WhitneyDesignLabs/STT-Dongle/(commit log)

2026-05-30 Initial commit: STT Keyboard Dongle (v0) — firmware, Android app, tooling, docs
    Phone speech-to-text -> BLE -> ESP32 USB-HID keyboard. Validated end-to-end on an
    ESP32-C6 BLE proxy; ESP32-S3 (HID-capable) board on order.
    - firmware/ ESP32-S3 production: USB-HID + bonded BLE GATT + Enter/Tab/Backspace (compiles)
    - firmware-ble-test/ ESP32-C6 BLE proxy: serial echo, LED activity, CLEAN_SERIAL + REQUIRE_BONDING flags
    - android/ (v0.7.0) Kotlin app: dictation, BLE console, multi-dongle, special keys (voice+buttons),
    keep-screen-awake, on-screen version
    - tools/ stt_send.py (BLE harness), serial_type.py (Windows software-HID), watch-install.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
2026-05-30 v0.8: working end-to-end STT -> BLE -> serial-bridge -> host insertion
    Full loop is functional on the ESP32-C6 stand-in (S3 USB-HID pending): dictate on
    the phone, text is inserted on the host via tools/serial_type.py. Adds Tier-1 special
    keys (Enter/Tab/Backspace, voice + buttons) and spoken punctuation (period/comma/etc.).
    Known (anticipated polish, not architectural):
    - voice punctuation required (ASR won't infer it)
    - 'new line' = Enter = send in chat boxes (no soft/hard split until the Tier-2 Control char)
    - silence chime on SpeechRecognizer restart
    - non-prose strings (URLs/paths) dictate poorly; need post-processing
    - dictation drops on screen-off (foreground-service item)
    See SESSI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
2026-05-30 Milestone: ESP32-S3 validated end-to-end on real hardware
    Production firmware flashed to the S3 (native USB port, USBMode=default, erase).
    Board enumerates as a standard USB-HID keyboard; phone dictation types live into the
    host over BLE -> S3 -> HID, incl. special keys + punctuation. Bonded cleanly. All four
    spec §8 milestones met. serial_type bridge now obsolete. No code change (existing
    firmware); records the validation in SESSION-LOG.
2026-05-30 Shippable v0.9 — S3 dongle working end-to-end (personal use)
    Real product on the ESP32-S3: phone dictation -> BLE -> USB-HID keyboard typing into
    any computer, with Tier-1 special keys (Enter/Tab/Backspace), spoken punctuation, and
    an onboard activity LED (S3 RGB on GPIO48). App v0.9.0 mutes STREAM_MUSIC while
    listening to reduce the recognizer chime.
    Known/tabled: recognizer silence chime not fully suppressed on Pixel (earcon on a
    protected stream; full fix = on-device recognizer, #14); #10 screen-off dictation;
    #13 Tier-2 control-char special keys; #15 non-prose post-processing.
    [firmware.ino]
2026-05-31 Internal release v0.9.0-internal — open build, BLE saga documented
    Ship the working unit for personal/internal use and lock the BLE-stability
    findings into the docs.
    What's shipped:
    - ESP32-S3 firmware flashed + typing phone dictation into any host over USB-HID,
    with special keys, spoken punctuation, and the activity LED. App v0.9.0.
    - Firmware runs the OPEN build (REQUIRE_BONDING=0): the bonded path is correct
    in principle but hits the BLE SMP 30-second timeout on the Arduino-ESP32
    Bluedroid stack and drops the link every ~31 s. Proven by A/B test — a
    non-pairing PC central was *also* dropped at +31 s; the open build holds steady.
    Security posture (known, accepted for private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
    [ble_hold.py, firmware.ino, serial_monitor.py]
2026-05-31 README: add hardware + app screenshots
    Show the real 3D-printed dongle (status LED glowing through the case) and the
    Android app's main screen ("Ready", live transcript, special keys, Start
    dictation). Images live in docs/images/ and render on the repo front page.
2026-06-01 README: add BLE Console screenshot (three-across showcase)
    Add the diagnostics/BLE Console screen (scan/connect, status + MTU, send test
    text, per-write delay, nearby-devices list) next to the hardware photo and the
    app main screen. docs/images/software2.jpg.
2026-06-01 README: swap BLE Console shot for a connected one (MAC masked)
    Replace the disconnected BLE Console screenshot with a live, connected capture:
    STATUS Ready, device name STT-Keyboard-A994, signal -50 dBm, MTU 256 bytes — a
    better demonstration of the console working. The dongle's BLE hardware address is
    pixelated/masked; the raw unmasked capture was never committed.
2026-06-01 Docs wrap-up: ROADMAP.md (replaces stale MORNING.md), session log + README links
    - Replace the outdated MORNING.md ("built overnight, enable USB") with a
    forward-looking ROADMAP.md: current state, the open-link security caveat, and
    the next builds — B (app auth token, #23) then C (full bonding via NimBLE, #22)
    — plus the polish/feature backlog.
    - SESSION-LOG.md: add the session-2 entry (public GitHub release, secret sweep,
    path genericization, MIT license, README screenshots with masked MAC) and a
    NEXT-SESSION pointer.
    - README: link ROADMAP.md from the doc index.
2026-06-01 Session log: roll current firmware to spares #2 & #3
    Flashed the two spare ESP32-S3 units with the shipped open build after #1
    ran clean for ~24h. Both HID-verified. Adds a reusable per-board flash flow
    for the 6 incoming boards.
2026-06-02 Build B (#23): app-level auth token — gate, NVS provisioning, tap-to-provision
    Firmware (behind REQUIRE_AUTH_TOKEN, default 0 — shipped open build stays
    byte-for-byte identical at 687407 bytes):
    - Control char (7a9b0002): central writes a shared token to unlock Text-Input
    for the connection; re-locks on every (re)connect.
    - Per-dongle token generated + persisted in NVS on first boot.
    - Provisioning char (7a9b0003): exposes the token only during an open window
    (power-on until first successful auth), enabling tap-to-provision.
    App v0.10.1:
    - BLE console auth-token field; token stored per dongle (by address).
    - Writes the saved token on connect; auto-READS + saves it on first connect t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
2026-06-02 Build B is now the default; deprecate open build; unique dongle names; docs
    Firmware:
    - REQUIRE_AUTH_TOKEN now defaults to 1 — the auth-token (gated) build is the
    preferred/default; the open build is an explicit opt-out (-DREQUIRE_AUTH_TOKEN=0).
    - Production builds (AUTH_DEBUG=0) never print the token on serial — tap-to-provision
    over BLE is the only path the secret travels.
    - Fix dongle naming: the old suffix used getEfuseMac() & 0xFFFF, i.e. the Espressif
    OUI prefix shared by every board (all came up "STT-Keyboard-A994"). XOR-fold the
    MAC words so each dongle gets a unique name.
    Docs:
    - README: gated build is the preferred default; open build deprecated; remove the
    BadUSB fr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
    [firmware.ino]
2026-06-02 Harden auth + fix repo accuracy (external audit follow-ups)
    Firmware (token gate hardening):
    - Constant-time token compare (no byte-by-byte early-out → not timing-attackable).
    - Brute-force lockout: after 5 wrong tokens, ignore Control writes for an
    exponential-backoff window (capped ~64s). Counters are GLOBAL so reconnecting
    can't reset them; cleared on a correct auth. (The 64-bit token already makes
    guessing infeasible; this closes the door cleanly.)
    - Clarify REQUIRE_BONDING: it's the DEPRECATED, default-off BLE-encryption path
    (not compiled in the normal build), retained only as the Build C (#22) starting
    point — distinct from REQUIRE_AUTH_TOKEN, which is the live protectio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
    [firmware.ino]
2026-06-03 README: replace 3D-printed dongle photo with the branded laser-cut wood case
